cruisemaniac/dissertation-trolley-x/hardware/TrolleyX_Revised_BOM.xlsx

Trolley-X — Physical Prototype: Revised Bill of Materials
Drivetrain & chassis retained in full (load-bearing build). Intel NUC + RealSense removed; Arduino + 720p webcam reused. Vision-follow on existing webcam; UWB optional.
S.No | Section | Item | Qty | Description | Status | Cost (AED) | UAE source / note
Fabrication & basic items
1 |  | Aluminium Chassis Fabrication | 1 | Base fabrication — load-bearing | Buy | 1500 | Local machine/fab shop (Dubai)
2 |  | Basket (plastic) | 1 | Off-the-shelf retail basket | Buy | 200 | Retail
3 |  | Sensor mounts & brackets | Multiple | 3D printed | Make | 250 | Campus / local 3D print
4 |  | Wiring and connectors | Multiple | — | Buy | 300 | Besomi / Edwin Robotics
Power system
5 |  | LiFePO4 battery pack | 1 | 12 V battery | Buy | 480 | Local battery supplier
6 |  | DC-DC voltage converter | 2 | 24->12 V and 12->5 V | Buy | 150 | Edwin Robotics / Besomi
7 |  | Emergency stop switch | 1 | Industrial E-Stop | Buy | 60 | Local industrial supplier
8 |  | Power distribution & fuse set | 1 | Electrical safety kit | Buy | 150 | Local
Motor & drive system
9 |  | High-torque DC gear motor w/ encoder | 2 | 30 W DC gear motor | Buy | 500 | Edwin Robotics / Besomi
10 |  | Motor drive | 1 | SmartDrive Duo MDDS30, 2-ch DC | Buy | 700 | Cytron / Edwin Robotics
11 |  | Caster wheel | 2 | — | Buy | 150 | Local hardware
12 |  | Rubber drive wheel | 2 | — | Buy | 250 | Edwin Robotics / local
Navigation & computation system
13 |  | LiDAR sensor | 1 | Slamtec RPLIDAR A1 | Buy | 450 | Edwin Robotics
14 |  | Motor controller | 1 | Arduino — ALREADY OWNED | Have | 0 | Owned (was AED 100)
15 |  | Onboard compute | 1 | Raspberry Pi 5, 16 GB (or tether laptop) | Buy | 700 | Edwin Robotics / Zero Ohm
16 |  | Vision camera | 1 | 720p USB webcam — ALREADY OWNED (replaces RealSense) | Have | 0 | Owned
BUILD SUBTOTAL — with onboard Raspberry Pi 5 |  |  |  |  |  | 5840
BUILD SUBTOTAL — laptop tethered (no Pi purchase) |  |  |  |  |  | 5140
Optional add-on: UWB follow kit (ESP32-UWB/DW3000 ×3–4, CW2-faithful) |  |  |  |  |  | 400
Removed vs original BOM
Intel NUC 11 (perception PC) |  |  |  |  |  | 1500
Intel RealSense D415 (depth camera) |  |  |  |  |  | 1700
Arduino (now owned, no purchase) |  |  |  |  |  | 100
Total removed |  |  |  |  |  | 3300
Original BOM total |  |  |  |  |  | 9140
Revised build (with Pi 5) |  |  |  |  |  | 5840
Saving vs original |  |  |  |  |  | 3300
