cruisemaniac/dissertation-trolley-x/docs/build-log/README.md

# Build log

Narrative record of the hardware bring-up - the raw problem-solving that produced
[../../hardware/wiring.md](../../hardware/wiring.md).

- `gemini-build-conversation.docx` - the full assistant chat covering funding,
  component ID, wiring, soldering, power, first drive, encoder calibration, and
  the Pi/ROS install. Kept for provenance; the distilled, correct wiring lives in
  hardware/wiring.md (trust that over the chat where they differ).

Good raw material for weekly blog posts (blog = 40% and the nearest deadline).
