cruisemaniac/dissertation-trolley-x/(commit log)

2026-07-02 the papers i'm leaning on - uwb follow and lidar safety
2026-08-17 wiring as it actually is now that the rover's fabricated - not what the bom claims
    [TrolleyX_Revised_BOM.xlsx]
2026-08-18 dumping the full build log so i dont lose the wiring notes
2026-08-20 ros nodes are in - base controller, cardputer teleop, lidar safety
2026-08-28 vendor the slamtec sllidar driver for the a1
2026-08-28 convert vendored sllidar_ros2 driver to a git submodule
    Pins to Slamtec/sllidar_ros2@3430009, the same commit the vendored
    copy matched, so the working tree content is unchanged.
2026-08-28 docs: update READMEs for sllidar_ros2 submodule
    Note the clone/init steps needed now that the driver is pulled in
    as a submodule instead of vendored files.
2026-09-04 added uwb reset service for both anchors
    [uwb_reset.py]
2026-09-04 feat: add launch files and enhance Arduino base controller with parameterization
2026-09-04 add uwb ranging driver for the two cart anchors (untested on hardware)
2026-09-04 make safety sectorized and directional (front/rear/left/right)
    Split the scan into FRONT/REAR/LEFT/RIGHT sectors in the cart frame and gate
    linear motion by direction: forward limited by the front sector, reverse by the
    rear, rotation still free. A wall ahead now blocks forward but lets the cart
    back away. /safety/state reports all four sector distances.
    [safety_braking.py]
2026-09-04 set safety bearing_offset to 180 deg (lidar mounted backwards)
    The RPLIDAR is mounted rotated 180 deg, so obstacles ahead of the cart were
    landing in the REAR sector. Pass bearing_offset_deg=180 to safety in bringup so
    the sectors match the cart frame.
2026-09-04 fix safety sector mapping for the flipped lidar mount
    The lidar is mounted flipped (reversed handedness), not merely rotated: front
    and back are swapped, but left and right read correctly. A 180 deg offset alone
    is a rotation, so it would also swap left/right. Add an invert_scan param that
    negates the beam angle, and set invert_scan + bearing_offset_deg=180 in bringup
    so all four sectors match the cart frame.
    [safety_braking.py]
2026-09-04 docs: sectorized safety, UWB driver, flipped mount, power finding
    Bring the docs up to the current build: sectorized directional safety and the
    new /safety/state format; the flipped-lidar bearing fix (invert_scan + 180);
    the variable-speed <dir> <pwm> serial contract; the uwb_ranging driver and the
    RYUW122 anchor/tag topology; and the Pi 5 power finding (LM2596 lane browns out
    under motor load - needs a dedicated 5V/5A feed).
2026-09-04 reduce ranging distance for prototype
2026-09-04 add esp32 uwb tag firmware (RYUW122 config + keep-alive)
    Operator-carried RYUW122 tag on an ESP32-WROVER. On boot it sets MODE=0,
    NETWORKID=TROLLEYX, ADDRESS=TAG00001 (matching the uwb_ranging node) and verifies
    +OK; then keeps the link alive and reconfigures if the module drops. UART remapped
    to GPIO25/26 because the WROVER's PSRAM uses the default 16/17.
2026-09-05 esp32 tag: drive RYUW122 NRST before config (reset quirk)
    The RYUW122_Lite has no reliable internal pull-up on NRST and stays silent on
    serial until NRST gets a clean low->high edge held high - the same quirk the Pi
    anchor reset service handles. Drive NRST from GPIO27: pulse low ~150 ms, release
    high, then configure. Also re-pulse on keep-alive recovery.
    [uwb_tag.ino]
2026-09-05 esp32 tag: correct RYUW122 pin order in wiring notes
    Real header order is GND . PA7 . TXD . RXD . NRST . VDD - VDD and GND sit at
    opposite ends, not adjacent. That wrong assumption was why the module was mute.
    Code was already correct (25/26/27); this fixes the wiring comment.
    [uwb_tag.ino]
2026-09-05 uwb_ranging: settle + retry anchor config (fix NETWORKID no-+OK)
    AT+MODE=1 flips the anchor into anchor mode and needs a beat before it accepts
    the next command, so NETWORKID was arriving too early and getting no ack. Wait
    after the mode change and retry each config command once. Manual test confirmed
    both anchors range the tag (47 / 45 cm) once NETWORKID is set.
    [uwb_ranging.py]
2026-09-05 add UWB follow controller + follow.launch.py
    Differential-ranging follower: steer on d_right-d_left, speed from mean range
    with a stand-off, hold forward until aligned, stop on stale UWB. Publishes
    /motion_request through safety_braking. follow.launch.py runs the full stack
    (lidar + safety + base + uwb + follow), no teleop.
2026-09-05 add flash-arduino.sh: flash the Uno from the Pi over USB (no unplug)
    Uses arduino-cli; the Uno auto-resets via DTR so no cable dance. Header documents
    the one-time arduino-cli + avr core + Adafruit MPU6050 setup. Refuses if the port
    is busy (stop the ROS base node first).
2026-09-05 arduino_base: publish gyro-aided /odom + /imu/data from telemetry
    Parse the 20 Hz CSV (left_m,right_m,accel_x,gyro_z) and publish sensor_msgs/Imu
    on /imu/data and nav_msgs/Odometry on /odom with the odom->base_link TF. Heading
    is integrated from the gyro (not the wheel difference), so it needs no track
    width and tolerates skid-steer slip; distance comes from the encoders. Gyro bias
    is averaged from a stationary startup window. Adds nav_msgs + tf2_ros deps.
    [arduino_base_controller.py]
2026-09-05 docs: /odom + /imu/data (gyro-aided), follow controller, dev order
    Record the odometry/IMU bridge in arduino_base, the completed follow controller,
    and mark the track-width question as no longer blocking odom heading. Next is the
    localisation EKF (UWB + odom + IMU).
2026-09-06 add UWB+odom EKF localizer (fused tag estimate)
    EKF fuses the two anchor ranges with /odom into a smooth tag position (odom-frame
    constant-velocity state), then publishes it in base_link on /follow/target and in
    odom on /uwb/tag_odom for RViz/eval. Time-multiplexed ranges are separate updates;
    an innovation gate rejects outliers. Validated on a synthetic moving-cart /
    walking-operator trajectory (0.21 m RMS vs 0.10 m raw noise). Adds numpy dep.
    [uwb_localizer.py]
2026-09-06 follow controller: consume EKF fused target (Kalman follow)
    Add a target mode (use_target): follow /follow/target from the EKF and steer on
    the true bearing + range instead of the raw range difference - smoother and
    robust to UWB dropouts. follow.launch now runs uwb_localizer and sets
    use_target=True; raw differential mode stays the default for the node.
